melmarszal/PET-extruder/README.md

# PET-extruder
This GitHub contains all files pertaining to the PET Extruder Senior Design Project of Amy Pang, Sam Leville, Blake Christiansen, and Melanie Marszal. Please visit our [website](https://thelittleengineersthatcould.github.io/)!
