melmarszal/PET-extruder/CAD/website.md

Please see our [website](https://thelittleengineersthatcould.github.io/CAD/) to download and view interactive models of all CAD components.
