melmarszal/PET-extruder/Presentations/4_10 Meeting Presentation.pptx

## Extra Meeting April 10, 2023

The Little Engineers that Could: Blake, Sam, Melanie, and Amy

## Last Week’s Progress

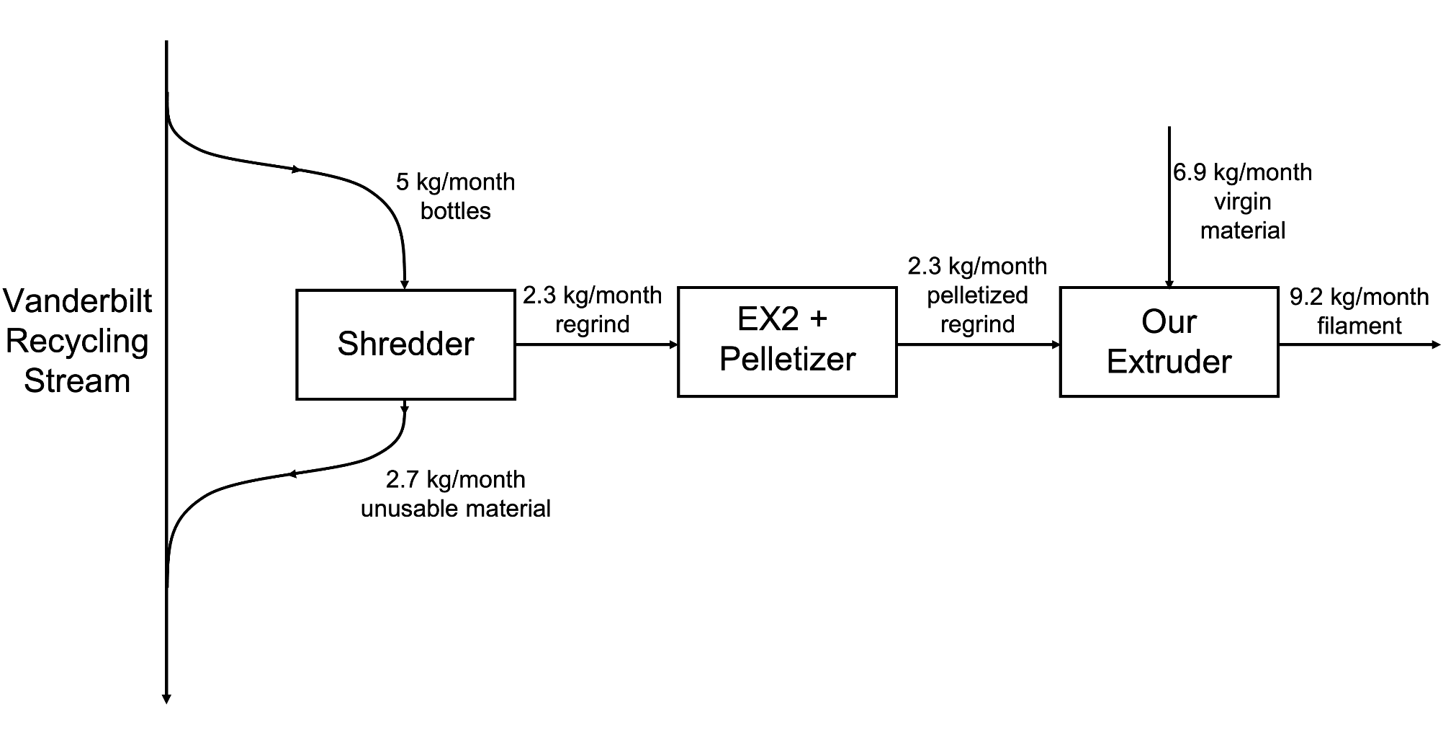
[picture p13: figure]

- Website is up, running, and getting better each day
  - Main focus is still finishing the extruder (wiring everything, putting parts together), but as more of the extruder is built, more time will be spent on writing
- Fans work, fan shrouds fit => just need to make sure housing can support weight and screws are long enough
  - ⅔ shrouds are printed
- We know how ⅔ of the PIDs are wired/programmed and will test them this week
- Made last order of big purchases (enough heaters for whole barrel, coupler, aluminum extrusion, connection to wall power)
- Characterized recycle stream and finished PFD (attached on next page)
- Filmed and edited Design Day video

## Next Steps

- Wire the rest of the PIDs
- Keep updating the website
- Still waiting on several items to ship in (housing, coupler, power supply, wall connector)
- Machining the flange and thermocouple connections
- Barrel bearing

## Questions

- Fastening heaters to barrel => what kind of tape (https://www.mcmaster.com/products/tape/?s=fiberglass+tape)?
- Is reimbursement an option, and if so, how could we go about that?

## “Keep calm and carry on”

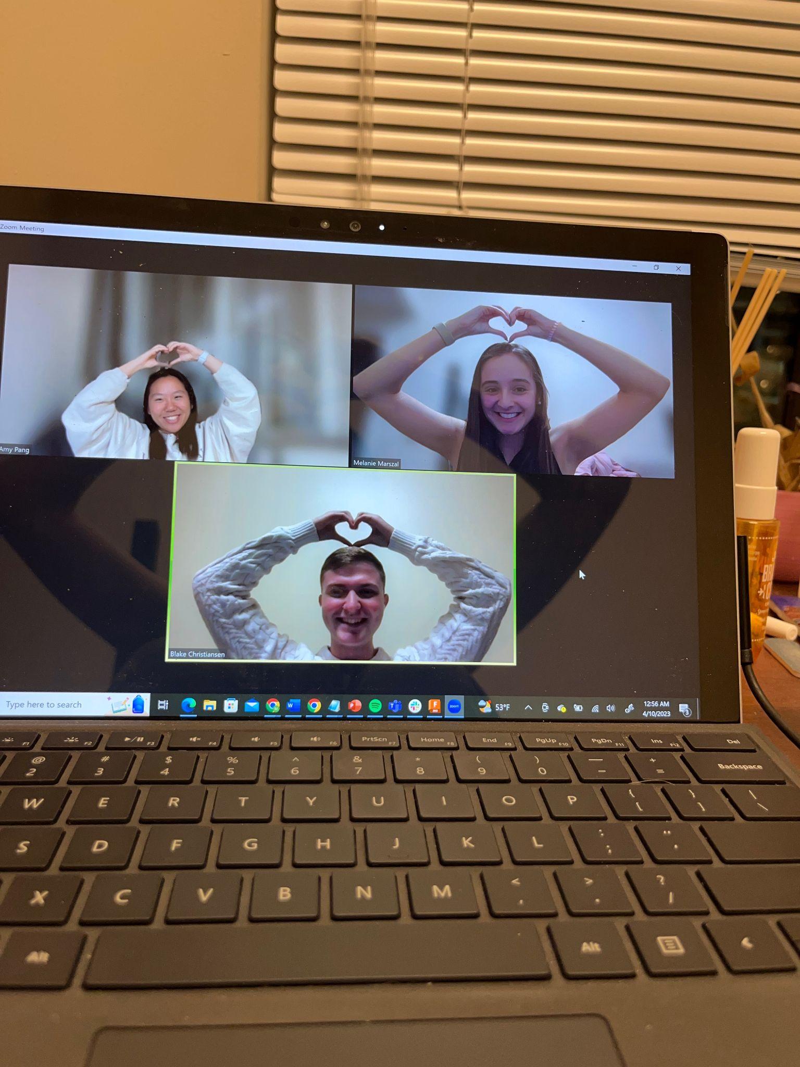
[picture p14: figure]

- Amy Pang
