melmarszal/PET-extruder/Report Components/HAZOP Senior Design.xlsx

Process Name: rPET Extruder | Node Analyzed: Extruder
Intetion:
Prepared By: Blake Christiansen, Sam Leville, Melanie Marszal, Amy Pang
Guide-Word | Guide-Word + Parameter | Cause | Consequence | Action
No | No flow through screw | Operator runs extruder without adding pellets to hopper; pellets clump together because of lack of heating | Galling may occur in which the metal screw and the metal barrel come into contact, causing damage to both. Pellet clumping may force the screw to become uncentered in which contact between the screw and barrel wall may occur too. | User manual outlines proper operational protocol; shear plate will break if pressure is too high, stopping screw from turning; operator shuts down machine via emergency stop button.
No | No heating element around screw | Heating connections become loose; heater breaks | Pellets do not completely melt. Pressure builds up in the barrel. PET crystallizes on the barrel wall. | PID controllers are programmed with a minimum set temperature of 240 C; shear plate will break if pressure is too high and the break will be audible, allowing the operator shuts down machine via emergency stop button.
Other Than | Other than PET pellets | Foreign objects are accidentally dropped into hopper, which can damage the machinery and disrupt the process; Foreign objects like hair, clothing, or fingers get caught in the rotating screw | Foreign materials can damage the screw and inner walls of the barrel. They can also affect the material properties and usability of the filament (product). They can prevent the flow in the screw, resulting in pressure build up in the screw and no product being extruded. Extreme damage and injuries can occur to the operator or whoever the foreign objects belong to, due to the power of the rotating machinery | Visual inspection of feed into the hopper, monitoring pressure and temperature sensors, metal detection of final product; operators or others on standby shut down the machine via emergency stop button and disconnect the power from the wall; user manual outlining safe attire and operation protocol.
More | More heating around screw | Heating unit not regulated; temperature PID set value is too high | Shear plate will break if pressure is too high and the break will be audible, allowing the operator shuts down machine via emergency stop button | PID controllers are programmed with a maximum set temperature of 270 C; in case of malfunction, operator shuts down machine via emergency stop button.
As Well As | As well as exposed heating elements | Housing that protects heating elements are damaged | Operators risk getting burned. The loss of heating may affect the material property of the filament. The loss of heating may change the flow viscosity in the screw, requiring more work from the motor than capable. | Visual inspection of the external extruder housing, temperature sensor measuring the temperature of the filament at the die/air interface, fiberglass insulation surrounding the barrel.
As Well As | As well as exposed electrical components | Housing that protects electrical components are damaged | Operators risk electrocution. Damage can occur to the electric components, potentially damaging the extruder system as a whole | Visual inspection of the external extruder housing, visual inspection of external sensors for proper measurements.
More | More moisture in the pellets | Upstream disruptions from PET pellet source; weather | Water in or around the pellets will boil, causing cosmetic changes in the filament. Die exit speed is changed. Bridging may occur in the hopper in which the pellets form aggregations and block the flow of material from the hopper to the barrel. | Water activity test of a few pellets from each batch.
Part Of | Part of barrel wall thickness decreases | Wear to the barrel over time from continuous melted pellet flow, screw becomes unbalanced and scrapes against the inner wall surface | Pressure rating for barrel will become inaccurate. The barrel will not be able to handle as much internal pressure, which could result in a rupture. | Shear plate will break if pressure is too high and the break will be audible, allowing the operator shuts down machine via emergency stop button. Bearing on the end of the screw ensures stability and prevents scraping.
Less | Less air flow from fans | Fans not set to adequate speed, one or multiple fan connections become loose | Temperature inside the housing will exceed operatable threshold, which may result in electron malfunction and changes in product's material properties. | Interlock with temperature sensor threshold if the internal temperature of the extruder exceeds upper set point limit.
