melmarszal/PET-extruder/Report Components/Simulation.docx

Simulations

To determine the optimal parameters for the screw of our extruder, we used NEXTRUCAD simulation software. NEXTRUCAD simulates single-screw extrusion. We use NEXTRUCAD to determine whether a theoretical extruder will fully melt a polymer and produce filament before building the extruder itself Additionally, the results of NEXTRUCAD allow us to properly size the motor, gearbox, and heaters and determine an economic feasibility analysis before investing any capital into an extruder project

The first step in determining the viscosity data for the polymer that you are looking to extrude. PET is a non-Newtonian fluid meaning its viscosity varies with shear in a Power Law relationship shown here:

η=m_0 ⋅e^(-b(T-T_r )) γ̇^n , η<η_T ⋅e^(-b(T-T_r )) …………………………(1)

where η is viscosity, m0 is the consistency at Tr, Tr is the reference temperature, b is the temperature sensitivity, γ̇ is the shear rate, n is the Power Law index, and ηT is the plateau viscosity. By fitting the data developed by Bata et al to equation (1), we were able to determine the values of m0, b, and n with a reference temperature of 270 ℃ as shown in Table 1.

Table 1. Power Law Parameter Values

Power Law Parameter | Value
m0 | 751.2 (Pa.s^n)
b | 0.03 (℃⁻¹)
n | 0.7459
TR | 270 (℃)
η | 207 (Pa.s^n)

As noted by other groups, PET extrusion generally works best with high compression screws (3.0:1 to 3.25) with a length around 24 screw diameters. Based on this knowledge and the difficulty of machining a custom screw, the team decided to purchase the High Compression Screw. Using the screw specifications from Filabot, we started to use NEXTRUCAD to design and simulate the remaining portions of the extruder.

All of the NEXTRUCAD inputs are summarized in Tables 2 - 7. The key results from the simulation can be found in Table 8. The outputs in Table 8 inform everything from our economic analysis (LINK HERE) to our equipment sizing (LINK HERE)

Table 2. NEXTRUCAD Screw (i) Inputs

Screw (i)
Screw Diameter (mm) | 16
Flight Clearance (D) | 0.001
Compression Ratio | 3

Table 3. NEXTRUCAD Screw (ii) Section 1 Inputs

Screw (ii)
Screw Section 1
Length (in) | 4
Screw Lead at Start (D) | 1
At end (D) | 1
Flight Width (D) | 0.1
Channel Depth at Start (in) | 0.24
At end (in) | 0.24

Table 4. NEXTRUCAD Screw (ii) Section 2 Inputs

Screw (ii)
Screw Section 2
Length (in) | 7.2
Screw Lead at Start (D) | 1
At end (D) | 1
Flight Width (D) | 0.1
Channel Depth at Start (in) | 0.24
At end (in) | 0.08

Table 5. NEXTRUCAD Screw (ii) Section 3 Inputs

Screw (ii)
Screw Section 3
Length (in) | 3.8
Screw Lead at Start (D) | 1
At end (D) | 1
Flight Width (D) | 0.1
Channel Depth at Start (in) | 0.08
At end (in) | 0.08

Table 6. NEXTRUCAD Barrel + Die Inputs

Barrel + Die
Smooth or Grooved | Smooth
Barrel friction coefficient | 0.35
Heating Zone 1 (in) | 4
Heating Zone 2 (in) | 7.2
Heating Zone 3 (in) | 3.8
Die length (mm) | 13
Die diameter (mm) | 1.75

Table 7. NEXTRUCAD Process Conditions Inputs

Process Conditions
Screw Speed (RPM) | 100
Heating Zone 1 (C) | 250
Heating Zone 1 (C) | 260
Heating Zone 1 (C) | 250
Screw Thermal State | Adiabatic
Material entering Temp (C) | 30
Melting Delay (D) | 3

Table 8. NEXTRUCAD Key Results

Result | Value
Output (kg/h) | 1.82
Max Pressure (MPa) | 5.97
Exit Temp (C) | 251.49
Melt Length (D) | 15.64
Power Consumption (kW) | 0.2
Torque (hp) | 0.26
Drag flow cap. (kg/h) | 3.14
Avg residence time (s) | 155.48
