melmarszal/PET-extruder/Economic Analysis/Extruder Component Costing.xlsx

Sheet: Full Cost List
Item Name | Order Date | Price per Unit ($) | Number of Units | Price ($) | Link | Ordered? | Arrived? | TOTAL COST | $5489.65
PET Bottle Recycler | 2023-02-11 | $286.00 | 1 | $286.00 | https://www.ebay.com/itm/334620570515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 | Yes | Yes
EX6 and MDPE10 extruder screws | 2023-02-11 | $869.00 | 1 | $869.00 | https://www.filabot.com/products/ex6-extruder-screws | Yes | Yes |  | *** Total Cost does not include items that don't have an order date
RPETG PELLETS | 2023-02-11 | $56.27 | 1 | $56.27 | https://www.filabot.com/collections/filament/products/rpetg-pellets | Yes | Yes
EX6 EXTRUDER NOZZLES - STYLE X | 2023-02-11 | $72.37 | 1 | $72.37 | https://www.filabot.com/collections/components/products/extruder-nozzles-style-x?variant=2053641830415 | Yes | Yes
IronHorse MTR series standard efficiency AC induction motor, general purpose and inverter rated, 1/2hp, 3-phase, 230/460 VAC, 1800rpm, TEFC, 56C frame, rolled steel, rigid base/C-face mount. | 2023-03-20 | $309.00 | 1 | $309.00 | https://www.radwell.com/en-US/Buy/AUTOMATION%20DIRECT/OPTIMATION%20INC/MTR2-P50-3BD18/ | Yes | Yes
IronHorse medium-duty worm gearbox, 10:1 ratio, 56C-Face input, hollow, 0.625in diameter output shaft, nominal 0.5hp at 1.0 SF, 150 lb-in mechanical output torque, 30mm center distance, cast aluminum housing, top and bottom mount. | 2023-03-20 | $139.00 | 1 | $139.00 | https://www.automationdirect.com/adc/shopping/catalog/power_transmission_(mechanical)/general_purpose_aluminum_worm_gearboxes/wga-30m-010-h1 | Yes | Yes
Variable Frequency Drive | 2023-03-20 | $118.84 | 1 | $118.84 | https://www.amazon.com/Wisoqu-Frequency-Single%E2%80%91Phase-Controller-AT5%E2%80%911500X/dp/B09H7J4M96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 | Yes | Yes
IronHorse gearbox single output shaft, 0.625in. For use with aluminum WGA-30M series gearboxes. (3) keys, (1) spacer and (1) retaining ring included. | 2023-03-22 | $16.50 | 1 | $16.50 | https://www.automationdirect.com/adc/shopping/catalog/power_transmission_(mechanical)/general_purpose_gearbox_accessories/wga-30m-acc3 | Yes | Yes
PID Temp Controller | 2023-03-22 | $197.45 | 3 | $592.35 | https://www.mcmaster.com/38615K71/ | Yes | Yes
High-Temperature Heater for Pipes and Tubes, 12" Long with Wire Leads (3641K22) | 2023-03-22 | $27.49 | 1 | $27.49 | https://www.mcmaster.com/coil-heaters/maximum-heat-output~550-f/maximum-heat-output~900-f/maximum-heat-output~1040-f/maximum-heat-output~1200-f/maximum-heat-o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 | Yes | Yes
High-Temperature Heater for Pipes and Tubes, 6" Long with Wire Leads (3641K21) | 2023-03-22 | $27.17 | 2 | $54.34 | https://www.mcmaster.com/coil-heaters/maximum-heat-output~550-f/maximum-heat-output~900-f/maximum-heat-output~1040-f/maximum-heat-output~1200-f/maximum-heat-o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 | Yes | Yes
12V 120mm Fan | 2023-03-22 | $19.99 | 3 | $59.97 | https://www.amazon.com/Wathai-5300rpm-Airflow-Brushless-Cooling/dp/B07SGWNV5J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 | Yes | Yes
RioRand 7-70V PWM DC Motor Speed Controller Switch 30A | 2023-03-22 | $15.99 | 3 | $47.97 | https://www.amazon.com/RioRand-7-80V-Motor-Controller-Switch/dp/B071NQ5G71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 | Yes | Yes
Toggle Switch, 2 Position, Round, Maintained, 2 Terminal, SPST-NO, 6A | 2023-03-22 | $8.54 | 3 | $25.62 | https://www.mcmaster.com/7343K184/ | Yes | Yes
Emergency Stop Button | 2023-03-22 | $12.99 | 1 | $12.99 | https://www.amazon.com/gp/product/B09MTMBX8Y?linkId=f5c970e37e969c8f6d6d67837862efe5&language=en_US | Yes | Yes
IEC Connector with Power Switch | 2023-03-22 | $19.85 | 1 | $19.85 | https://www.mcmaster.com/5428N332/ | Yes | Yes
Power Supply | 2023-03-22 | $12.99 | 2 | $25.98 | https://www.amazon.com/ALITOVE-Universal-Regulated-Switching-Transformer/dp/B078RY6YY3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 | Yes | Yes
Rubber Feet | 2023-03-22 | $10.99 | 1 | $10.99 | https://www.amazon.com/192310GS-Vibration-Isolator-Compressors-Generators/dp/B09LHK1FTH | Yes | Yes
PCS Black Angle Sharp Corner Bracket Connector for 6mm Slot Aluminum Extrusion Profile 2020 Series | 2023-03-22 | $9.99 | 15 | $149.85 | https://www.amazon.com/Befenybay-Bracket-Connector-Aluminum-Extrusion/dp/B08HCSPZ6G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 | Yes | Yes
K Type Thermocouple M8 thread | 2023-03-22 | $6.76 | 5 | $33.80 | https://www.amazon.com/Thermocouple-Sensor-Probes-0-400%E2%84%83-Temperature/dp/B07R537LL1 | Yes | Yes | Only two have arrived (BC, 6APR23)
Fiberglass Insulation Sheets (9356K12) | 2023-03-22 | $35.20 | 1 | $35.20 | https://www.mcmaster.com/insulation/fiberglass-insulation-sheets/ | Yes | Yes
Round Stock Material for barrel | 2023-03-27 | $101.12 | 1 | $101.12 | https://www.mcmaster.com/6101N58/ | Yes | Yes
Square Stock Material for feed section | 2023-03-27 | $180 | 1 | $180 | https://www.mcmaster.com/6547K71/ | Yes | Yes
1-1/8-7 Die for threads | 2023-03-27 | $135.79 | 1 | $135.79 | https://www.mcmaster.com/2576A751/ | Yes | Yes
Wrench for round die | 2023-03-27 | $91.09 | 1 | $91.09 | https://www.mcmaster.com/25565A27/ | Yes | Yes
1-1/8-7 Tap | 2023-03-27 | $126.68 | 1 | $126.68 | https://www.mcmaster.com/2521A582/ | Yes | Yes
7/8-14 Tap | 2023-03-27 | $63.98 | 1 | $63.98 | https://www.mcmaster.com/2521A689/ | Yes | Yes
Large Tap handle | 2023-03-27 | $124.74 | 1 | $124.74 | https://www.mcmaster.com/2546A16/ | Yes | Yes
Lathe Turning tool set | 2023-03-27 | $157.84 | 1 | $157.84 | https://www.mcmaster.com/3240A126/ | Yes | Yes
41/64” Extended Length Drill bit | 2023-03-27 | $103.62 | 1 | $103.62 | https://www.mcmaster.com/2464A47/ | Yes | Yes
Top Plate | 2023-04-03 | $165.92 | 1 | $165.92 | Send-Cut-Send | Yes | No
Side Panel Fan Side | 2023-04-03 | $82.33 | 1 | $82.33 | Send-Cut-Send | Yes | No
Logo Plate | 2023-04-03 | $128.46 | 1 | $128.46 | Send-Cut-Send | Yes | No
Front Plate | 2023-04-03 | $48.99 | 1 | $48.99 | Send-Cut-Send | Yes | No
Base Plate | 2023-04-03 | $350.92 | 1 | $350.92 | Send-Cut-Send | Yes | No
Back Plate | 2023-04-03 | $49.47 | 1 | $49.47 | Send-Cut-Send | Yes | No
Clamping Precision Flexible Shaft Coupling | 2023-04-08 | $153.12 | 1 | $153.12 | https://www.mcmaster.com/6208K687/ | Yes | No
304 Stainless Steel Wire Cloth | 2023-04-08 | $26.49 | 1 | $26.49 | https://www.mcmaster.com/9207T208/ | Yes | No
AC Power Connector | 2023-04-08 | $9.49 | 1 | $8.99 | https://www.amazon.com/Cablelera-North-American-Extension-ZWACPFAC-08/dp/B00GMPVAJM | Yes | No
Power Supply | 2023-04-08 | $12.99 | 1 | $12.99 | https://www.amazon.com/ALITOVE-Universal-Regulated-Switching-Transformer/dp/B078RY6YY3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 | Yes | Yes
IEC Connector (1333N14) | 2023-04-08 | $17.33 | 1 | $17.33 | https://www.mcmaster.com/1333N14 | Yes | No
8 position dual row terminal strip block | 2023-04-08 | $14.89 | 1 | $14.89 | https://www.amazon.com/Positions-Terminal-Pre-Insulated-Barrier-MILAPEAK/dp/B07CM1JQCR?cv_ct_cx=bus%2Bbar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 | Yes | Yes
6 Colors 10Ft Each 16AWG Electric Wire | 2023-04-08 | $22.49 | 1 | $22.49 | https://www.amazon.com/Fermerry-Silicone-Stranded-Automotive-Electronic/dp/B089CVMBNC?s=hi | Yes | Yes
Electrical Crimp Terminal for 16-14AWG Cable | 2023-04-08 | $8.89 | 1 | $8.89 | https://www.amazon.com/Insulated-Connectors-Electrical-Terminals-MILAPEAK/dp/B07Q2R23NR?s=hi | Yes | Yes
Aluminum Extrusion | 2023-04-08 | $68.89 | 1 | $68.89 | https://www.amazon.com/Aluminum-Extrusion-High-Strength-Anodizing-Technology/dp/B09KZMP48N | Yes | No
60" High-Temperature Heater for Pipes and Tubes | 2023-04-08 | $83.67 | 2 | $167.34 | https://www.mcmaster.com/3641K25 | Yes | No
96" High-Temperature Heater for Pipes and Tubes | 2023-04-08 | $113.90 | 1 | $113.90 | https://www.mcmaster.com/3641K26 | Yes | No
Socket to fit tang
M6 x 16 mm screws (for Hopper)
T Nuts

Sheet: Total Capital Investment
Equipment Type | Cost
Motor Train (Screw, Motor, Gear Box, etc.) | $1558.99
Electrical (VFD, Power Supplies, wires, etc.) | $291.36
Heating/Cooling (Heaters, Fans, PID, etc.) | $1072.39
Structure (Housing, Aluminimum Extrusion, etc.) | $1082.31
Machining (Taps, Lathe Turning, etc.) | $1084.86
3D Printing Material | ~ $0
Prototyping Risk | $343.47
Total Capital Investment | $5433.38

Sheet: Motor Train
Motor Train
EX6 and MDPE10 extruder screws | 2023-02-11 | $869.00 | 1 | $869.00
EX6 EXTRUDER NOZZLES - STYLE X | 2023-02-11 | $72.37 | 1 | $72.37
IronHorse MTR series standard efficiency AC induction motor, general purpose and inverter rated, 1/2hp, 3-phase, 230/460 VAC, 1800rpm, TEFC, 56C frame, rolled steel, rigid base/C-face mount. | 2023-03-20 | $309.00 | 1 | $309.00
IronHorse medium-duty worm gearbox, 10:1 ratio, 56C-Face input, hollow, 0.625in diameter output shaft, nominal 0.5hp at 1.0 SF, 150 lb-in mechanical output torque, 30mm center distance, cast aluminum housing, top and bottom mount. | 2023-03-20 | $139.00 | 1 | $139.00
IronHorse gearbox single output shaft, 0.625in. For use with aluminum WGA-30M series gearboxes. (3) keys, (1) spacer and (1) retaining ring included. | 2023-03-22 | $16.50 | 1 | $16.50
Clamping Precision Flexible Shaft Coupling | 2023-04-08 | $153.12 | 1 | $153.12
 |  |  |  | $1558.99

Sheet: Electrical
Electrical
Variable Frequency Drive | 2023-03-20 | $118.84 | 1 | $118.84
RioRand 7-70V PWM DC Motor Speed Controller Switch 30A | 2023-03-22 | $15.99 | 3 | $47.97
Emergency Stop Button | 2023-03-22 | $12.99 | 1 | $12.99
Power Supply | 2023-03-22 | $12.99 | 3 | $25.98
AC Power Connector | 2023-04-08 | $9.49 | 1 | $8.99
Power Supply | 2023-04-08 | $12.99 | 1 | $12.99
IEC Connector (1333N14) | 2023-04-08 | $17.33 | 1 | $17.33
8 position dual row terminal strip block | 2023-04-08 | $14.89 | 1 | $14.89
6 Colors 10Ft Each 16AWG Electric Wire | 2023-04-08 | $22.49 | 1 | $22.49
Electrical Crimp Terminal for 16-14AWG Cable | 2023-04-08 | $8.89 | 1 | $8.89
 |  |  |  | $291.36

Sheet: HeatingCooling
Heating/Cooling
PID Temp Controller | 2023-03-22 | $197.45 | 3 | $592.35
High-Temperature Heater for Pipes and Tubes, 12" Long with Wire Leads (3641K22) | 2023-03-22 | $27.49 | 1 | $27.49
High-Temperature Heater for Pipes and Tubes, 6" Long with Wire Leads (3641K21) | 2023-03-22 | $27.17 | 2 | $54.34
K Type Thermocouple M8 thread | 2023-03-22 | $6.76 | 5 | $33.80
Fiberglass Insulation Sheets (9356K12) | 2023-03-22 | $35.20 | 1 | $35.20
60" High-Temperature Heater for Pipes and Tubes | 2023-04-08 | $83.67 | 2 | $167.34
96" High-Temperature Heater for Pipes and Tubes | 2023-04-08 | $113.90 | 1 | $113.90
 |  |  |  | $1024.42

Sheet: Structure
Structure
Rubber Feet | 2023-03-22 | $10.99 | 1 | $10.99
PCS Black Angle Sharp Corner Bracket Connector for 6mm Slot Aluminum Extrusion Profile 2020 Series | 2023-03-22 | $9.99 | 15 | $149.85
Top Plate | 2023-04-03 | $165.92 | 1 | $165.92
Side Panel Fan Side | 2023-04-03 | $82.33 | 1 | $82.33
Logo Plate | 2023-04-03 | $128.46 | 1 | $128.46
Front Plate | 2023-04-03 | $48.99 | 1 | $48.99
Base Plate | 2023-04-03 | $350.92 | 1 | $350.92
Back Plate | 2023-04-03 | $49.47 | 1 | $49.47
304 Stainless Steel Wire Cloth | 2023-04-08 | $26.49 | 1 | $26.49
Aluminum Extrusion | 2023-04-08 | $68.89 | 1 | $68.89
 |  |  |  | $1082.31

Sheet: Machining
Machining
Round Stock Material for barrel | 2023-03-27 | $101.12 | 1 | $101.12 | $5041.94 | 5489.65
Square Stock Material for feed section | 2023-03-27 | $180 | 1 | $180 | 387.74
1-1/8-7 Die for threads | 2023-03-27 | $135.79 | 1 | $135.79 | $5429.68
Wrench for round die | 2023-03-27 | $91.09 | 1 | $91.09 | $59.97
1-1/8-7 Tap | 2023-03-27 | $126.68 | 1 | $126.68
7/8-14 Tap | 2023-03-27 | $63.98 | 1 | $63.98
Large Tap handle | 2023-03-27 | $124.74 | 1 | $124.74
Lathe Turning tool set | 2023-03-27 | $157.84 | 1 | $157.84
41/64” Extended Length Drill bit | 2023-03-27 | $103.62 | 1 | $103.62
 |  |  |  | $1084.86

Sheet: Production CostRevenue
Cost/Revenue Source | Value | Cost/Revenue Source | Value
PETG Filament | $31.50 / kg | Storage Cost | $268.00 / 6 months
rPETG Pellets | $56.27 / 5 kg | Electricity | $0.1065 / kWh
Labor | $10.00 / hr / person | Amazon Fulfillment | $4.94 / kg
Product Shipping | $250.00 / 100 kg | Amazon Referral | 12% of revenue

Sheet: Bill of Materials (Mechanical)
Item Name | Order Date | Price per Unit ($) | Number of Units | Price ($)
EX6 and MDPE10 extruder screws | 2023-02-11 | $869.00 | 1 | $869.00
EX6 EXTRUDER NOZZLES - STYLE X | 2023-02-11 | $72.37 | 1 | $72.37
IronHorse MTR series standard efficiency AC induction motor, general purpose and inverter rated, 1/2hp, 3-phase, 230/460 VAC, 1800rpm, TEFC, 56C frame, rolled steel, rigid base/C-face mount. | 2023-03-20 | $309.00 | 1 | $309.00
IronHorse medium-duty worm gearbox, 10:1 ratio, 56C-Face input, hollow, 0.625in diameter output shaft, nominal 0.5hp at 1.0 SF, 150 lb-in mechanical output torque, 30mm center distance, cast aluminum housing, top and bottom mount. | 2023-03-20 | $139.00 | 1 | $139.00
IronHorse gearbox single output shaft, 0.625in. For use with aluminum WGA-30M series gearboxes. (3) keys, (1) spacer and (1) retaining ring included. | 2023-03-22 | $16.50 | 1 | $16.50
Clamping Precision Flexible Shaft Coupling | 2023-04-08 | $153.12 | 1 | $153.12
High-Temperature Heater for Pipes and Tubes, 12" Long with Wire Leads (3641K22) | 2023-03-22 | $27.49 | 1 | $27.49
High-Temperature Heater for Pipes and Tubes, 6" Long with Wire Leads (3641K21) | 2023-03-22 | $27.17 | 2 | $54.34
K Type Thermocouple M8 thread | 2023-03-22 | $6.76 | 5 | $33.80
Fiberglass Insulation Sheets (9356K12) | 2023-03-22 | $35.20 | 1 | $35.20
60" High-Temperature Heater for Pipes and Tubes | 2023-04-08 | $83.67 | 2 | $167.34
96" High-Temperature Heater for Pipes and Tubes | 2023-04-08 | $113.90 | 1 | $113.90
Round Stock Material for barrel | 2023-03-27 | $101.12 | 1 | $101.12
Square Stock Material for feed section | 2023-03-27 | $180 | 1 | $180
1-1/8-7 Die for threads | 2023-03-27 | $135.79 | 1 | $135.79
Wrench for round die | 2023-03-27 | $91.09 | 1 | $91.09
1-1/8-7 Tap | 2023-03-27 | $126.68 | 1 | $126.68
7/8-14 Tap | 2023-03-27 | $63.98 | 1 | $63.98
Large Tap handle | 2023-03-27 | $124.74 | 1 | $124.74
Lathe Turning tool set | 2023-03-27 | $157.84 | 1 | $157.84
41/64” Extended Length Drill bit | 2023-03-27 | $103.62 | 1 | $103.62
 |  |  |  | $3075.92

Sheet: Bill of Materials (Electrical)
Item Name | Order Date | Price per Unit ($) | Number of Units | Price ($)
Variable Frequency Drive | 2023-03-20 | $118.84 | 1 | $118.84
RioRand 7-70V PWM DC Motor Speed Controller Switch 30A | 2023-03-22 | $15.99 | 3 | $47.97
Emergency Stop Button | 2023-03-22 | $12.99 | 1 | $12.99
Power Supply | 2023-03-22 | $12.99 | 3 | $25.98
AC Power Connector | 2023-04-08 | $9.49 | 1 | $8.99
Power Supply | 2023-04-08 | $12.99 | 1 | $12.99
IEC Connector (1333N14) | 2023-04-08 | $17.33 | 1 | $17.33
8 position dual row terminal strip block | 2023-04-08 | $14.89 | 1 | $14.89
PID Temp Controller | 2023-03-22 | $197.45 | 3 | $592.35
Electrical Crimp Terminal for 16-14AWG Cable | 2023-04-08 | $8.89 | 1 | $8.89
 |  |  |  | $861.22
