melmarszal/PET-extruder/Economic Analysis/Extruder Rough Cost Estimate.xlsx

Item | Quantity | Cost | Source
Screw | 1 | $500.00 | total guess
Barrel | 1 | $300.00 | total guess
Housing | 1 | $95.40 | see calcs (print it ourselves out of PLA?)
Hopper | 1 | $176.41 | https://www.filabot.com/products/ex6-hopper?variant=29571942711330&currency=USD
Gearbox | 1 | $547.37 | https://www.mcmaster.com/5887K32
Motor | 1 | $674.59 | https://www.mcmaster.com/6135K114
Cooling Fans | 3 | $22.97 | https://www.mcmaster.com/1976K91
Heater | 3 | $59.39 | https://www.mcmaster.com/4550T151
Power Supply | 1 | $521.40 | 7010K145
PID Controller | 3 | $188.04 | 38615K71
Temperature Probe | 3 | $43.52 | 9251T76
Die | 1 | $650.00 | https://profileprecisionextrusions.com/blog/benefits-of-custom-aluminum-extrusion-dies/
Total |  | $4406.93
 |  |  |  | PLA for casing: Thickness: 1/2 cm
 |  |  |  | Filabot Dimensions: (75.44cm x 23.11cm x 21.34cm)
 |  |  |  | https://www.filabot.com/collections/ex6-extruder/products/filabot-ex6-filament-extruder?variant=237592379407
 |  |  |  | Relevant Volume: 3846.4754 cm^3
 |  |  |  | Weight = 4.770 kg
 |  |  |  | Cost: $95.40
