melmarszal/PET-extruder/Materials Testing/Bottle Characteristic.xlsx

Bottle Brand | Size (fl oz) | Number in Bag | Weight | Usable Weight
Coca Cola/Sprite | 12 | 7
Coca Cola/Sprite | 16.9 | 15
Coca Cola/Sprite | 20 | 26
Coca Cola/Sprite | 24 | 2
Pepsi Co | 16.9 | 11
Pepsi Co | 20 | 6
Dr. Pepper | 16.9 | 16
Dr. Pepper/Mellow Yellow/Fanta | 20 | 11
Coca Cola/Sprite | 1.25 L | 1
Coca Cola/Sprite | 2 L | 1
A&W Rootbeer | 16.9 | 2
Vitamin Water | 20 | 1
Dr Pepper | 12 | 1
Cherry Bundi
Gatorade | 20 | 41
Gatorade | 12 | 1
Gatorlite | 20 | 1
Powerade | 28 | 5
Gatorade | 28 | 10
 |  |  |  |  | round aluminum coupler
 |  |  |  |  | machine out the square
 |  |  |  |  | motor on pelletizer
 |  |  |  |  | torque rating * gearbox ratio
