melmarszal/PET-extruder/CAD/testsheetmetalfinal.dxf

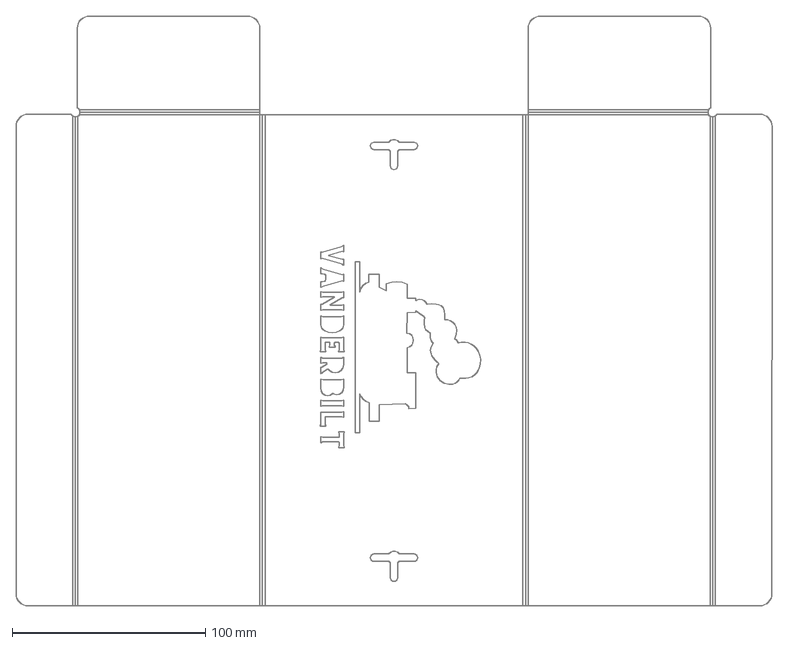
[picture p43: CAD file, 2023-03-06, last stored version]
CAD/testsheetmetalfinal.dxf
391.1 x 305.1 mm
