melmarszal/PET-extruder/X2 Testing/Taking Apart X2.docx

1. Pop rivets out of casing(26 of them) we lost one of the rivets (not the cap)

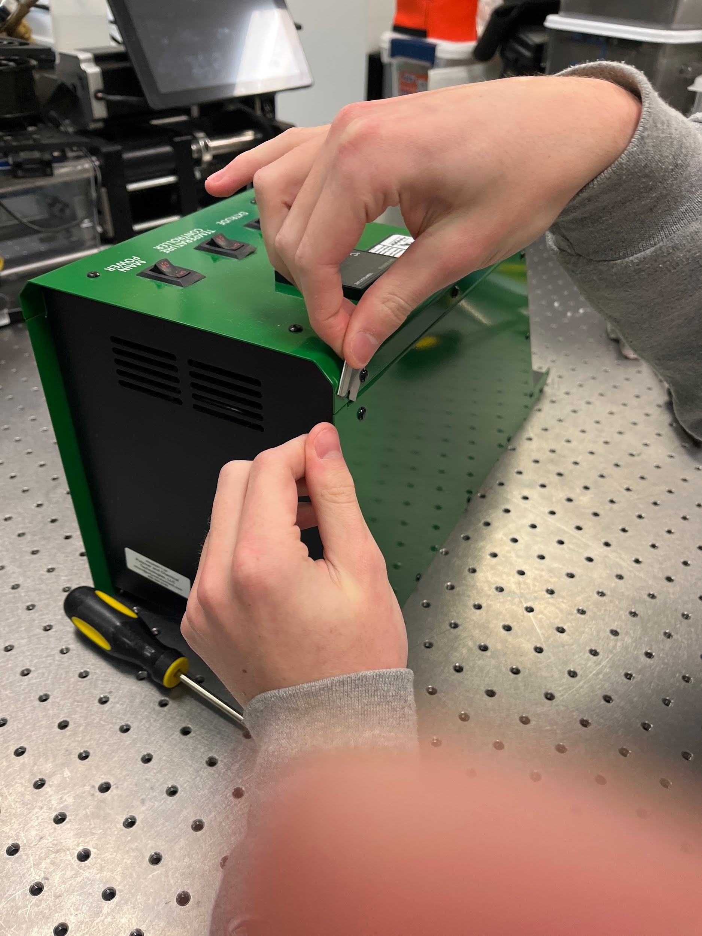
[picture p44: figure]

1. Take housing panel on side off
2. Take other side off
3. Slide off insulation panel
4. Unscrew things on top

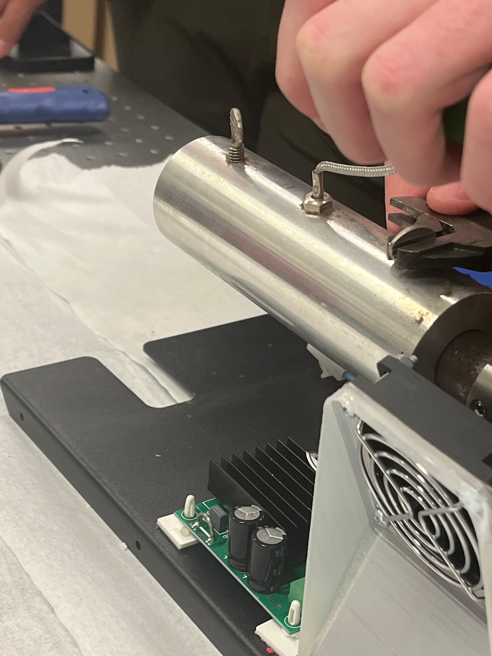
[picture p45: figure]

7. Unscrewed zebra screws

8.

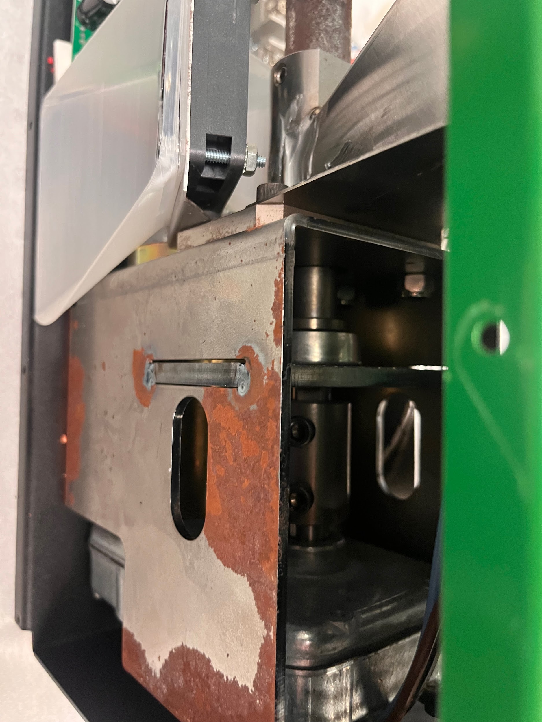
[picture p46: figure]

9. Take off cooling fan

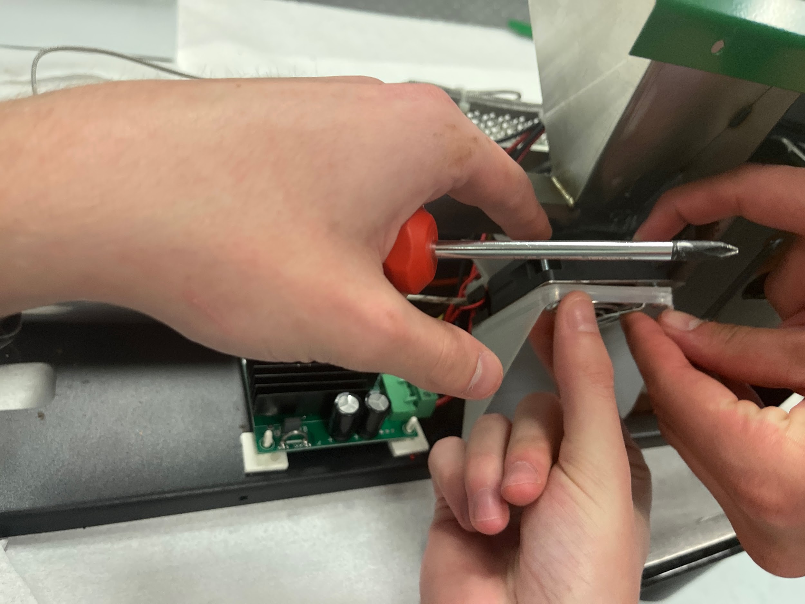
[picture p47: figure]

10.

Notes on the design:

This barrel only has support on the end. Since ours will be longer, it will need multiple supports along its length
