melmarszal/PET-extruder/Materials Testing/Link to Melt Flow Tester.docx

https://www.instron.com/en-us/products/testing-systems/rheology/melt-flow-index-testers#mf20
