melmarszal/PET-extruder/Report Components/FMEA_Extruder.xlsx

Sheet: FMEA - Blank
Process or Product Name: | rPET Extruder |  |  |  |  | Prepared by: Amy Pang, Melanie Marszal, Blake Christiansen, Sam Leville
Responsible: | Extruder Operator (Student Research Assistant) |  |  |  |  | FMEA Date (Orig): 4/14/2023 (Rev):
Process Step/Input | Potential Failure Mode | Potential Failure Effects | SEV | Potential Causes | OCC | Current Controls | DET | RPN
What is the process step/ Input under investigation? | In what ways does the key input go wrong? | What is the impact on the key output variables (customer requirements) or internal requirements? | How severe is the effect to the customer? | What causes the key input to go wrong? | How often does cause or failure mode occur? | What are the existing controls that prevent either the cause or the failure mode? | How well can you detect the cause/failure before next step?
Make regrind | Non PET bottles are mixed into the bottle source | Filament has inconsistent chemical and material properties | 4 | Improper sorting of bottles | 3 | Check for #1 code on or near the bottom of the bottles to verify that they are made of PET. | 7 | 84
Barrel Pressure | Pressure inside the barrel exceeds the barrel's allowable pressure. | Filament can not be produced because no flow will continue through the barrel | 9 | Pellets do not melt and clog the barrel, resulting in backflow and a bulid up of pressure | 2 | A shear plate is located on the output shaft, so that if the screw begins to move backwards the shear plate will break. | 7 | 126
Heating | Heating temperatures are far above the specified temperatures. | Filament being produced has a low viscosity, changing the strength properties. | 7 | Temperature PID controllers malfunction or are not tuned correctly. | 2 | Final filament temperature is monitored by a temperature sensor | 4 | 56
Electronic Wiring | Wiring is not done correctly. | Entire machine could be damaged | 10 | Improper wiring from manufacturers | 2 | Operators check the wiring of each individual component of the extruder. | 3 | 60
Feeding Raw Materials | Objects other than PET pellets enter the hopper, with special concern for hair, clothing, and body parts getting caught in the machinery. | Operators could be seriously injured or be fatally harmed if hair, clothing, or body parts are caught in the screw. | 10 | Proper PPE is not worn by the operators and the hopper is not covered pellets are not being fed. | 4 | Hopper should be covered with a lid when pellets are not being added to the hopper. | 10 | 400
Screw Stability | The screw wobbles or slants within the barrel. | The inside of the barrel could be scraped, decreasing its pressure rating and potentially causing the barrel to rupture. | 10 | Pellets are not fed to the running extruder, the screw is not securely attached to the coupler. | 2 | A bearing is placed on the end of the screw where it enters the flange to ensure stability | 3 | 60
Fan | Power to the fan is shuts off. | Internal components of the extruder such as the barrel and electronics are overheated. | 8 | Wires short circuit or power plug is damaged, resulting in the fans to turn off. | 2 | Fiberglass insulation is placed around the barrel to trap and isolate the heat around the barrel and prevent the rest of the extruder from getting too hot. | 5 | 80

Sheet: Criteria - sample
 | Severity | Occurrence | Detection
Rating | How severe is the effect on the customer? | How often does the cause or failure mode occur? | How well can you detect the cause or the failure mode before passing to next step?
10 | Serious hazard to people or damage to equipment | Very high chance of occurrence | Almost impossible to detect, no controls in place
9
8
7 | Customer dissatisfied, disruption to business | Moderate chance of occurrence | Low chance of detecting, may have some controls in place
6
5
4 | Customer may notice but only minor concern, minor disruption to business | Low chance of occurrence | High chance of detecting, controls are in place
3
2
1 | No effect | Remote chance of occurrence | Almost certain to detect, reliable controls are in place

Sheet: FMEA - Cell Phone Sample
Process or Product Name: | Using a Cell Phone |  |  |  |  | Prepared by: Ed the Expert |  |  | Page 1 of 1
Responsible: | Phyllis the Phone Owner |  |  |  |  | FMEA Date (Orig): February 22, 2006 (Rev): March 11, 2006
Process Step/Input | Potential Failure Mode | Potential Failure Effects | SEV | Potential Causes | OCC | Current Controls | DET | RPN | Actions Recommended | Resp. | Actions Taken | pSEV | pOCC | pDET | pRPN
What is the process step/ Input under investigation? | In what ways does the key input go wrong? | What is the impact on the key output variables (customer requirements) or internal requirements? | How severe is the effect to the customer? | What causes the key input to go wrong? | How often does cause or failure mode occur? | What are the existing controls that prevent either the cause or the failure mode? | How well can you detect the cause/failure before next step? |  | What are the actions for reducing the RPN. Should have actions only on high RPN's or easy fixes. | Who is responsible for the recommended action? | What actions have been taken and date completed?
Make a call | Battery is dead | Can not make the call | 7 | Long calls on long drives | 10 | -Reminder beep -Battery symbol | 7 | 490 | Car phone charger | Phyllis |  | 7 | 1 | 7 | 49
Make a call | Poor signal | Call interrupted with static | 5 | Out of phone range | 3 | -Antenna symbol -Stay in range | 7 | 105 | New phone service | Ed |  | 5 | 1 | 7 | 35
Receive a call | Poor signal | Call interrupted with static | 5 | Out of phone range | 3 | -Antenna symbol -Stay in range | 7 | 105 | New phone service | Ed |  | 5 | 1 | 7 | 35
Make a call | Battery is dead | Can not make the call | 7 | Bad battery will not hold charge | 1 | None | 10 | 70 |  |  |  | 7 | 1 | 10 | 70
Receive a call | Battery is dead | Can not receive call | 7 | Bad battery will not hold charge | 1 | None | 10 | 70 |  |  |  | 7 | 1 | 10 | 70
 |  |  |  |  |  |  |  | 0 |  |  |  |  |  |  | 0
 |  |  |  |  |  |  |  | 0 |  |  |  |  |  |  | 0
 |  |  |  |  |  |  |  | 0 |  |  |  |  |  |  | 0
 |  |  |  |  |  |  |  | 0 |  |  |  |  |  |  | 0
 |  |  |  |  |  |  |  | 0 |  |  |  |  |  |  | 0
 |  |  |  |  |  |  |  | 0 |  |  |  |  |  |  | 0
 |  |  |  |  |  |  |  | 0 |  |  |  |  |  |  | 0
