melmarszal/PET-extruder/CAD/Extruder Barrel Design Drawing With Threading v1.pdf

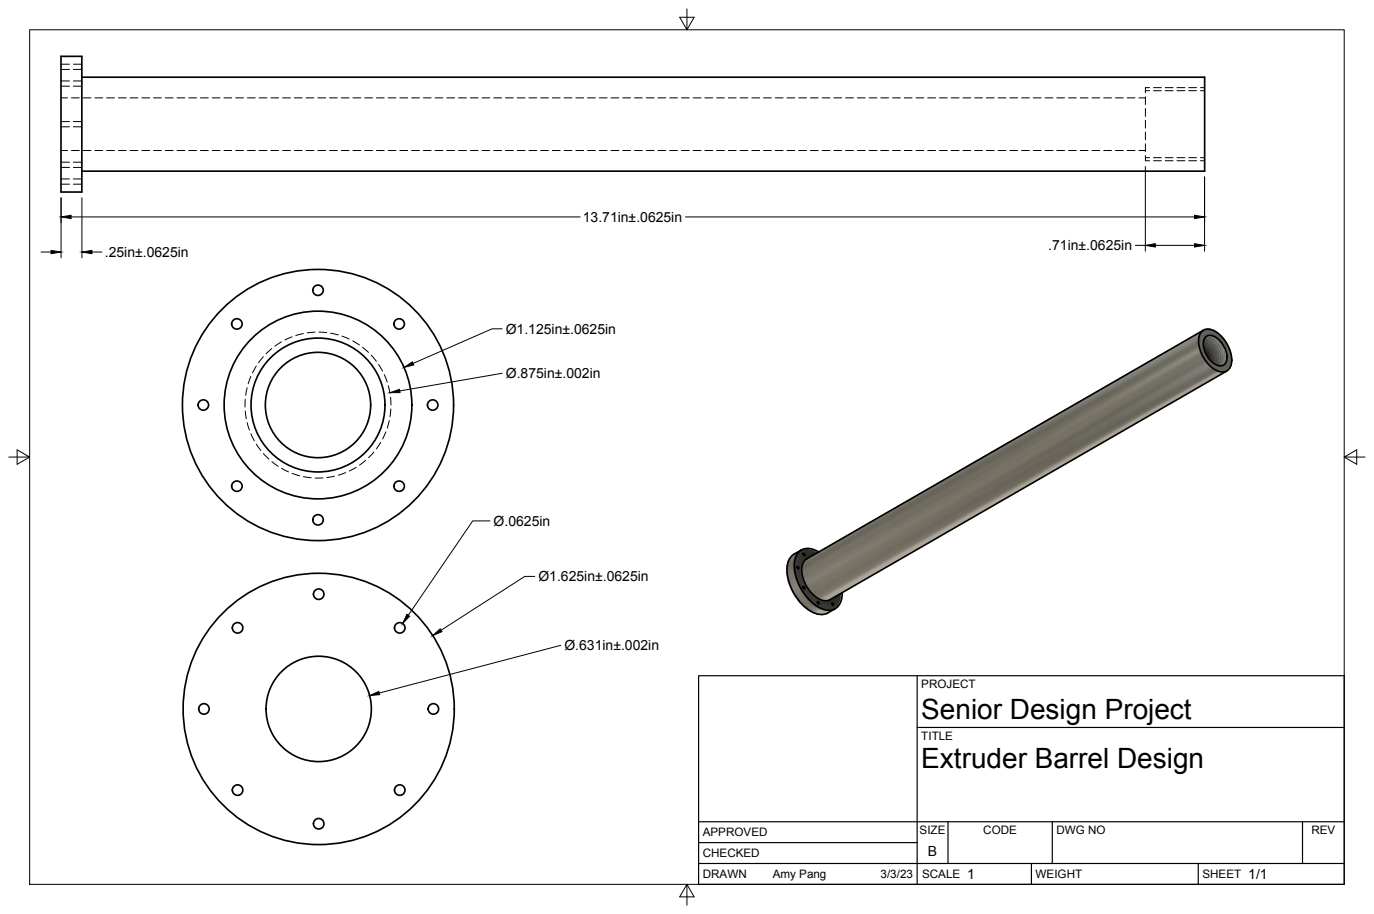
[picture p48: page 1]
SIZE; CODE; DWG NO; REV; Amy Pang

PROJECT
Senior Design Project
Extruder Barrel Design
