melmarszal/PET-extruder/(commit log)

2022-12-09 updates for semester 1 presentation
    [Extruder Rough Cost Estimate.xlsx]
2023-01-19 added meeting notes from 1/18 and viscosity data from existing paper
    [Recyled PET Viscosity Data (Estimated).xlsx]
2023-02-06 added notes, slides, and documents from 2/6 meeting
    [NEXTRUCAD Iterations.xlsx]
2023-02-20 2/20 meeting updates
    [Extruder Component Costing.xlsx, Gantt Chart.xlsx, HAZOP Senior Design.xlsx]
2023-03-06 Updated for 3/6 meeting
    [Extruder Component Costing.xlsx, Gantt Chart.xlsx, testsheetmetalfinal.dxf]
2023-03-21 updated from 3/20 meeting. no updated SOW
    [Bottle Characteristic.xlsx, Extruder Component Costing.xlsx]
2023-04-04 updated from 4/2 meeting
    [Extruder Component Costing.xlsx]
2023-04-26 post design day
    [Extruder Component Costing.xlsx, FMEA_Extruder.xlsx, Gantt Chart.xlsx, HAZOP Senior Design.xlsx, Simulation Tables.xlsx, testsheetmetalfinal.dxf]
